ryood/Dual_OTA_VCA/eagle/Dual_OTA_VCA_brd.png

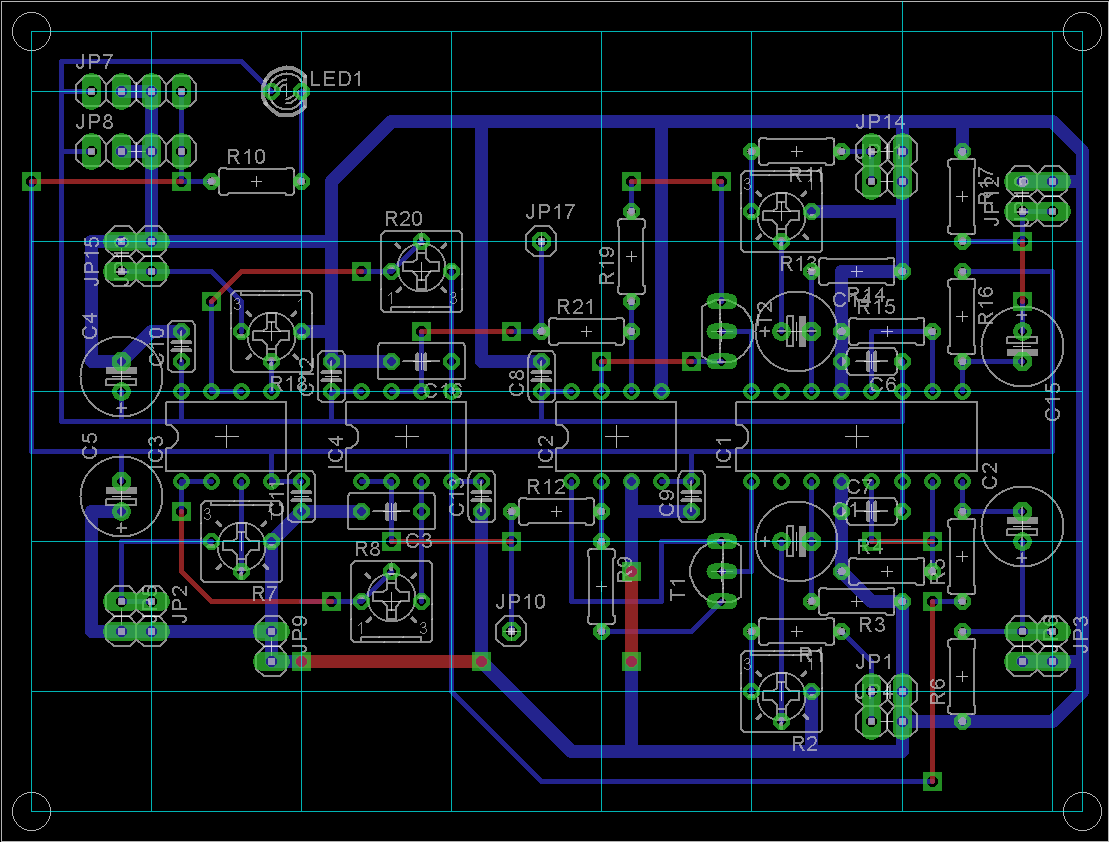
eagle/Dual_OTA_VCA_brd.png
