ryood/Dual_OTA_VCA/eagle/Dual_OTA_VCA_brd_PCB.png

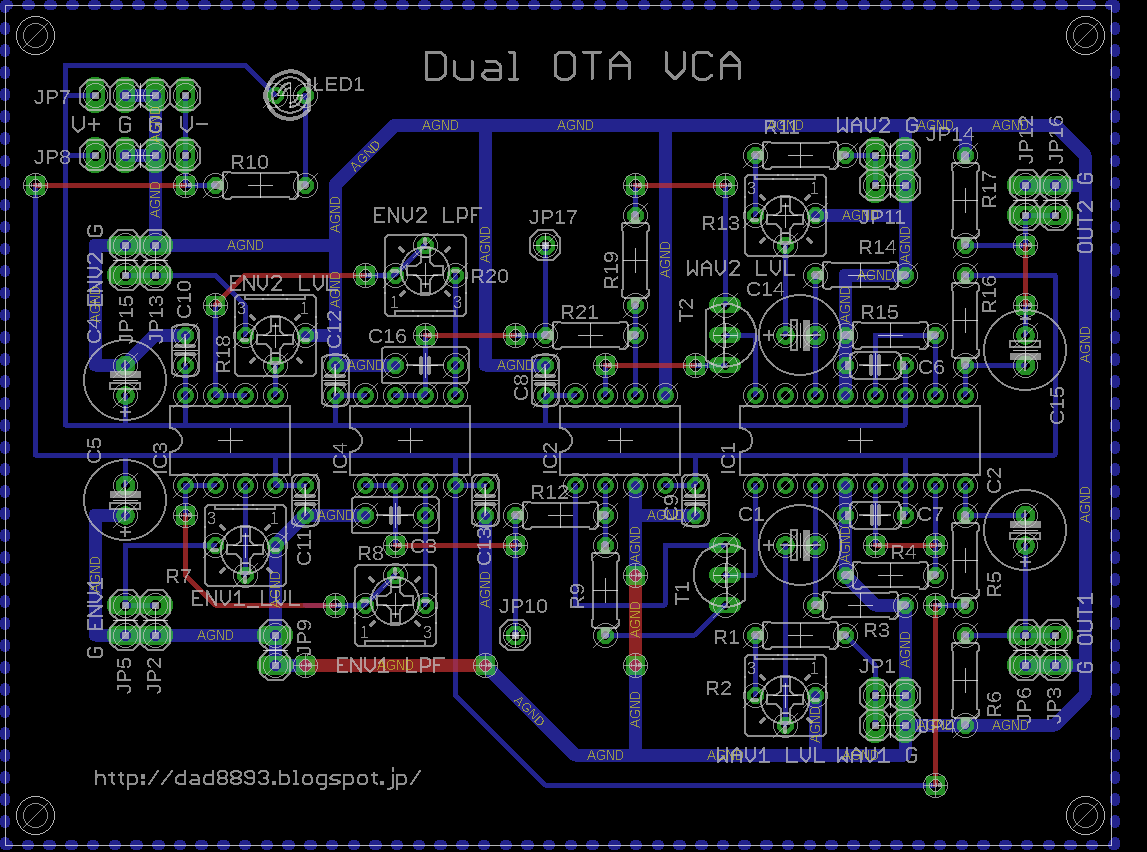
eagle/Dual_OTA_VCA_brd_PCB.png
