ryood/Dual_OTA_VCA/eagle/Dual_OTA_VCA_sch.png

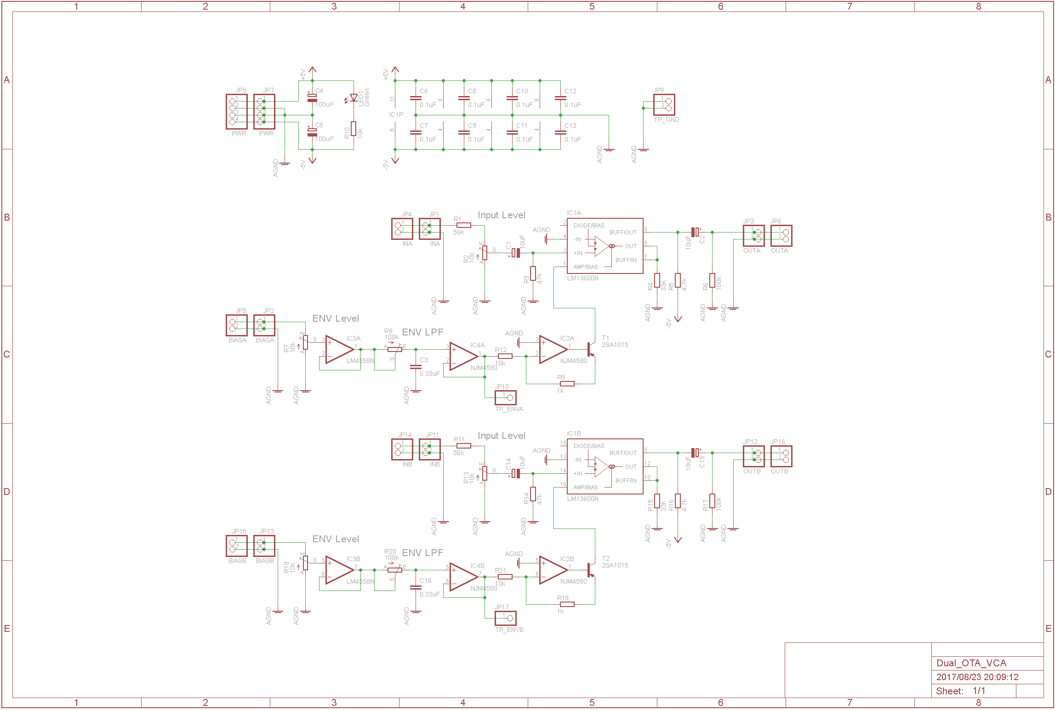
eagle/Dual_OTA_VCA_sch.png
