ryood/Dual_OTA_VCA/OTA_VCAの構成.png

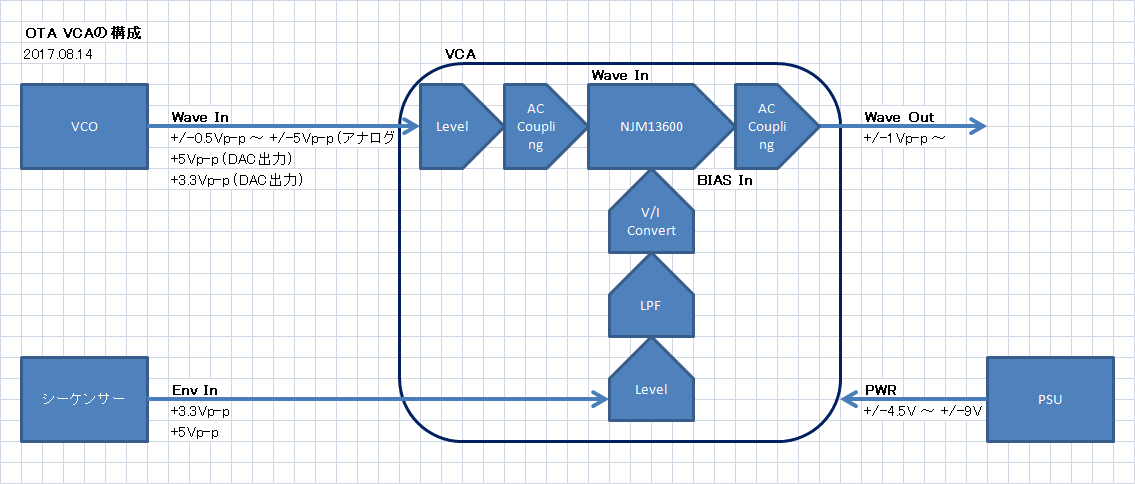
OTA_VCAの構成.png
