ryood/Dual_OTA_VCA/spice/V-I Convert wLPF Amp.png

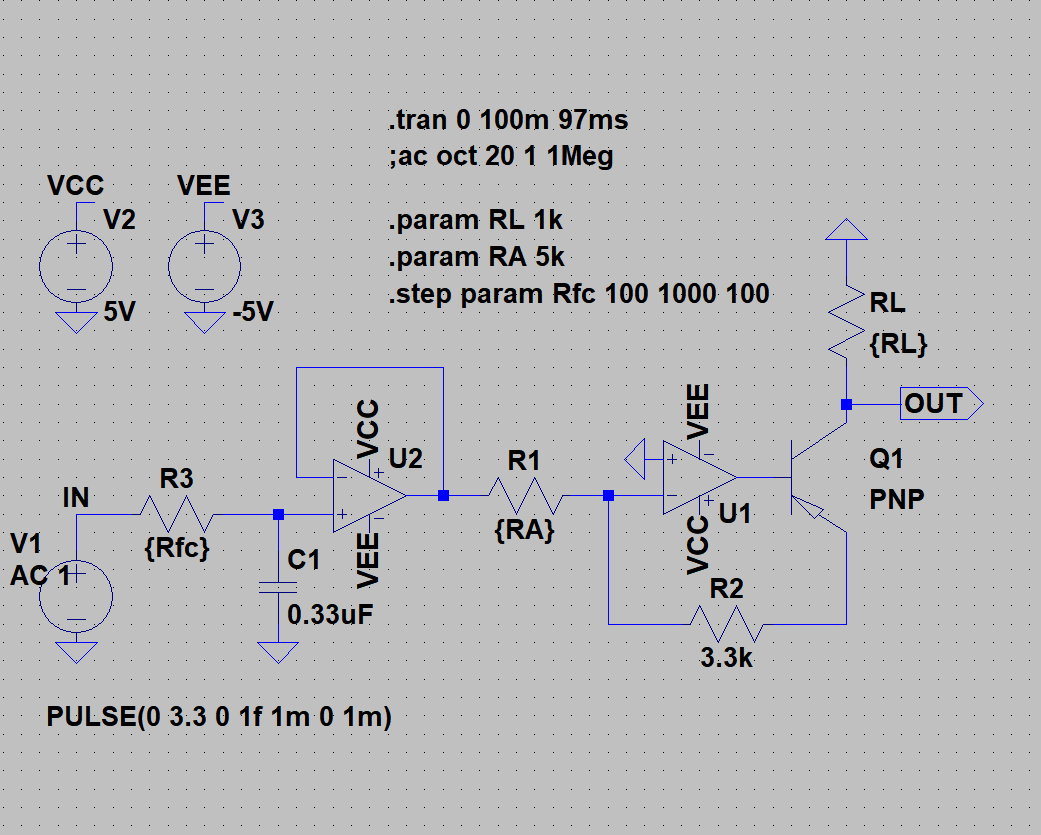
spice/V-I Convert wLPF Amp.png
