ryood/Dual_OTA_VCA/spice/V-I Convert wLPF Att2_sch.png

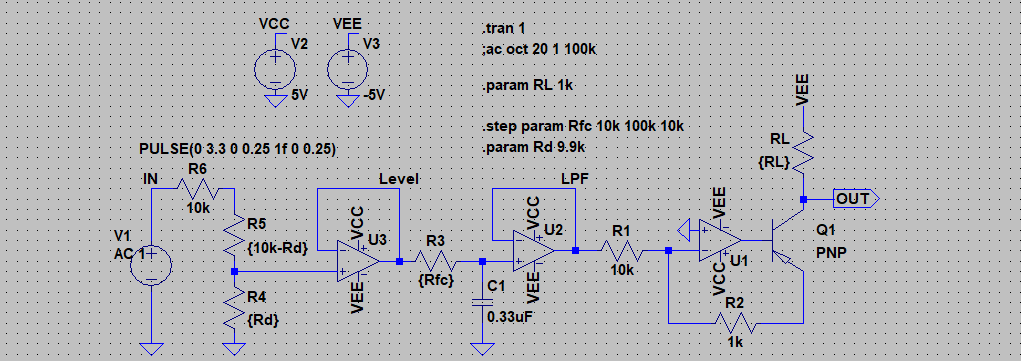
spice/V-I Convert wLPF Att2_sch.png
