ryood/Dual_OTA_VCA/Dual_OTA_VCA_BOM.xlsx

Sheet: Dual_OTA_VCA_BOM (2)
Dual OTA VCA BOM
2018.04.11
Part | Device | Value | Package | Qty | note
C1,C2,C14,C15 | 電解コンデンサ | 10uF | E2,5-7 | 4
C3,C16 | フィルムコンデンサ | 0.33uF | C050-030X075 | 2
C4,C5 | 電解コンデンサ | 100uF | E2,5-7 | 2
C6,C7,C8,C9,C10,C11,C12,C13 | 積セラ | 0.1uF | C050-024X044 | 8
IC1 | OTA | NJM13700 | DIL16 | 1
IC2,IC3,IC4 | OPAMP | NJM4580 | DIL08 | 3
JP1,JP2,JP3,JP9,JP11,JP12,JP13 | ピンヘッダ-1X2 |  | 1X02 | 7
JP4,JP5,JP6,JP14,JP15,JP16 | ピンソケット-1X2 |  | 1X02 | 6
JP7 | AMP/EI-1X4 | PWR | 1X04 | 1
JP8 | ピンソケット-1X4 | PWR | 1X04 | 1
JP10,JP17 | テスト端子 | TP_ENV | 1X01 | 2
LED1 | LED 3mm | Green | LED3MM | 1
R1,R11 | 抵抗 | 56k | 0207/7 | 2
R3,R14 | 抵抗 | 47k | 0207/7 | 2
R4,R15 | 抵抗 | 33k | 0207/7 | 2
R5,R16 | 抵抗 | 4.7k | 0207/7 | 2
R6,R17 | 抵抗 | 100k | 0207/7 | 2
R9,R19 | 抵抗 | 1k | 0207/7 | 2
R10,R12,R21 | 抵抗 | 10k | 0207/7 | 3
R2,R7,R13,R18 | トリマ | 10k | B25P | 4
R8,R20 | トリマ | 100k | B25P | 2
T1,T2 | PNPトランジスタ | 2SA1015 | TO92-ECB | 2
 | ICソケット |  | DIP-16 | 1
 | ICソケット |  | DIP-8 | 3

Sheet: Dual_OTA_VCA_BOM
Dual OTA VCA BOM
2018.04.04
Part | Device | Value | Package | note | note
C1 | 電解コンデンサ | 10uF | E2,5-7
C2 | 電解コンデンサ | 10uF | E2,5-7
C3 | フィルムコンデンサ | 0.33uF | C050-030X075
C4 | 電解コンデンサ | 100uF | E2,5-7
C5 | 電解コンデンサ | 100uF | E2,5-7
C6 | 積セラ | 0.1uF | C050-024X044
C7 | 積セラ | 0.1uF | C050-024X044
C8 | 積セラ | 0.1uF | C025-024X044
C9 | 積セラ | 0.1uF | C025-024X044
C10 | 積セラ | 0.1uF | C025-024X044
C11 | 積セラ | 0.1uF | C025-024X044
C12 | 積セラ | 0.1uF | C025-024X044
C13 | 積セラ | 0.1uF | C025-024X044
C14 | 電解コンデンサ | 10uF | E2,5-7
C15 | 電解コンデンサ | 10uF | E2,5-7
C16 | フィルムコンデンサ | 0.33uF | C050-030X075
IC1 | OTA | NJM13700 | DIL16
IC2 | OPAMP | NJM4580 | DIL08
IC3 | OPAMP | NJM4580 | DIL08
IC4 | OPAMP | NJM4580 | DIL08
JP1 | ピンヘッダ-1X2 | INA | 1X02
JP2 | ピンヘッダ-1X2 | BIASA | 1X02
JP3 | ピンヘッダ-1X2 | OUTA | 1X02
JP4 | ピンソケット-1X2 | INA | 1X02
JP5 | ピンソケット-1X2 | BIASA | 1X02
JP6 | ピンソケット-1X2 | OUTA | 1X02
JP7 | AMP/EI-1X4 | PWR | 1X04
JP8 | ピンソケット-1X4 | PWR | 1X04
JP9 | ピンヘッダ-1X2 | TP_GND | 1X02
JP10 | テスト端子 | TP_ENVA | 1X01
JP11 | ピンヘッダ-1X2 | INB | 1X02
JP12 | ピンヘッダ-1X2 | OUTB | 1X02
JP13 | ピンヘッダ-1X2 | BIASB | 1X02
JP14 | ピンソケット-1X2 | INB | 1X02
JP15 | ピンソケット-1X2 | BIASB | 1X02
JP16 | ピンソケット-1X2 | OUTB | 1X02
JP17 | テスト端子 | TP_ENVB | 1X01
LED1 | LED 3mm | Green | LED3MM
R1 | 抵抗 | 56k | 0207/7
R2 | トリマ | 10k | B25P
R3 | 抵抗 | 47k | 0207/7
R4 | 抵抗 | 33k | 0207/7
R5 | 抵抗 | 4.7k | 0207/7
R6 | 抵抗 | 100k | 0207/7
R7 | トリマ | 10k | B25P
R8 | トリマ | 100k | B25P
R9 | 抵抗 | 1k | 0207/7
R10 | 抵抗 | 10k | 0207/7
R11 | 抵抗 | 56k | 0207/7
R12 | 抵抗 | 10k | 0207/7
R13 | トリマ | 10k | B25P
R14 | 抵抗 | 47k | 0207/7
R15 | 抵抗 | 33k | 0207/7
R16 | 抵抗 | 4.7k | 0207/7
R17 | 抵抗 | 100k | 0207/7
R18 | トリマ | 10k | B25P
R19 | 抵抗 | 1k | 0207/7
R20 | トリマ | 100k | B25P
R21 | 抵抗 | 10k | 0207/7
T1 | PNPトランジスタ | 2SA1015 | TO92-ECB
T2 | PNPトランジスタ | 2SA1015 | TO92-ECB
 | ICソケット | 16pin
 | ICソケット | 8pin
 | ICソケット | 8pin
 | ICソケット | 8pin
