ryood/Dual_OTA_VCA/eagle/OTA_VCA_Test_sch.png

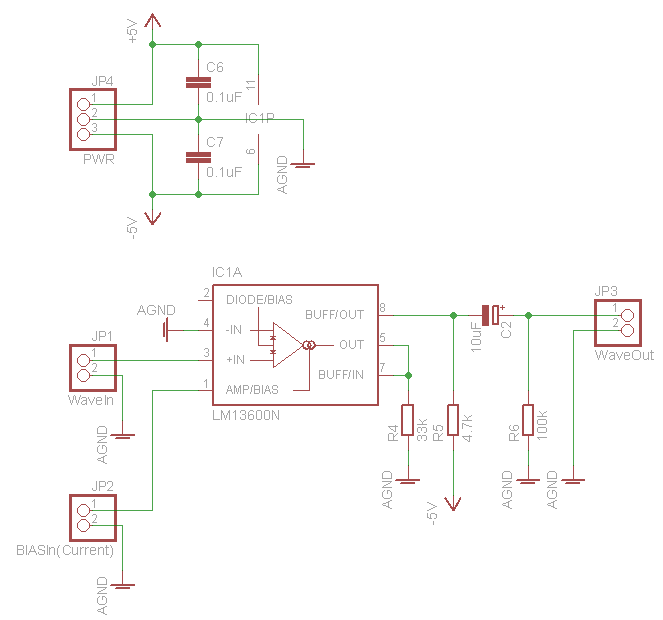
eagle/OTA_VCA_Test_sch.png
