ryood/Dual_OTA_VCA/fritzing/Dual_OTA_VCA_1ch_Test_ブレッドボード.png

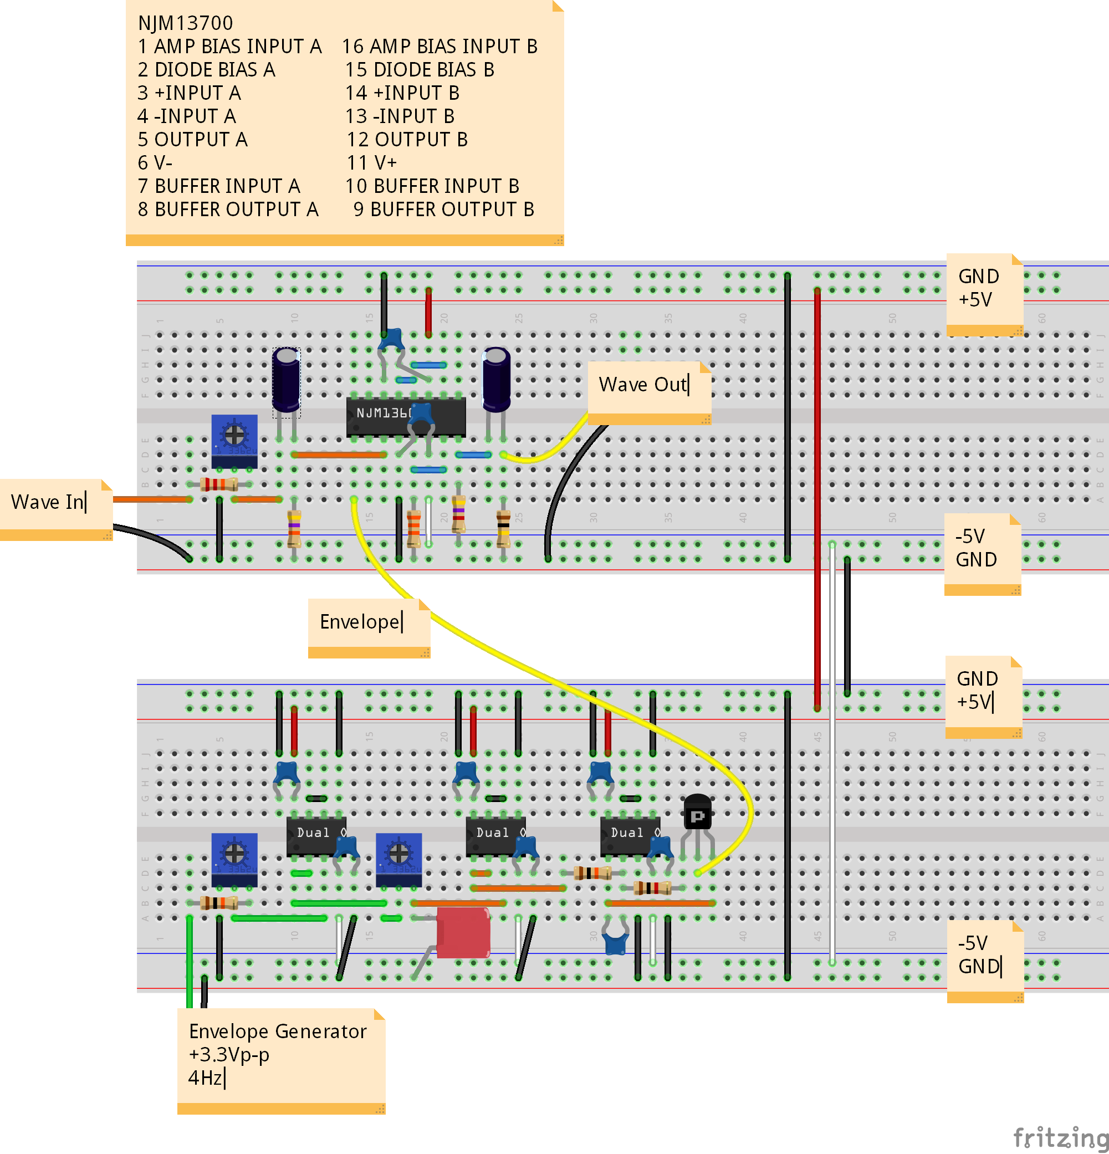
fritzing/Dual_OTA_VCA_1ch_Test_ブレッドボード.png
