ryood/Dual_OTA_VCA/fritzing/Dual_OTA_VCA_ch_Test_ブレッドボード.png

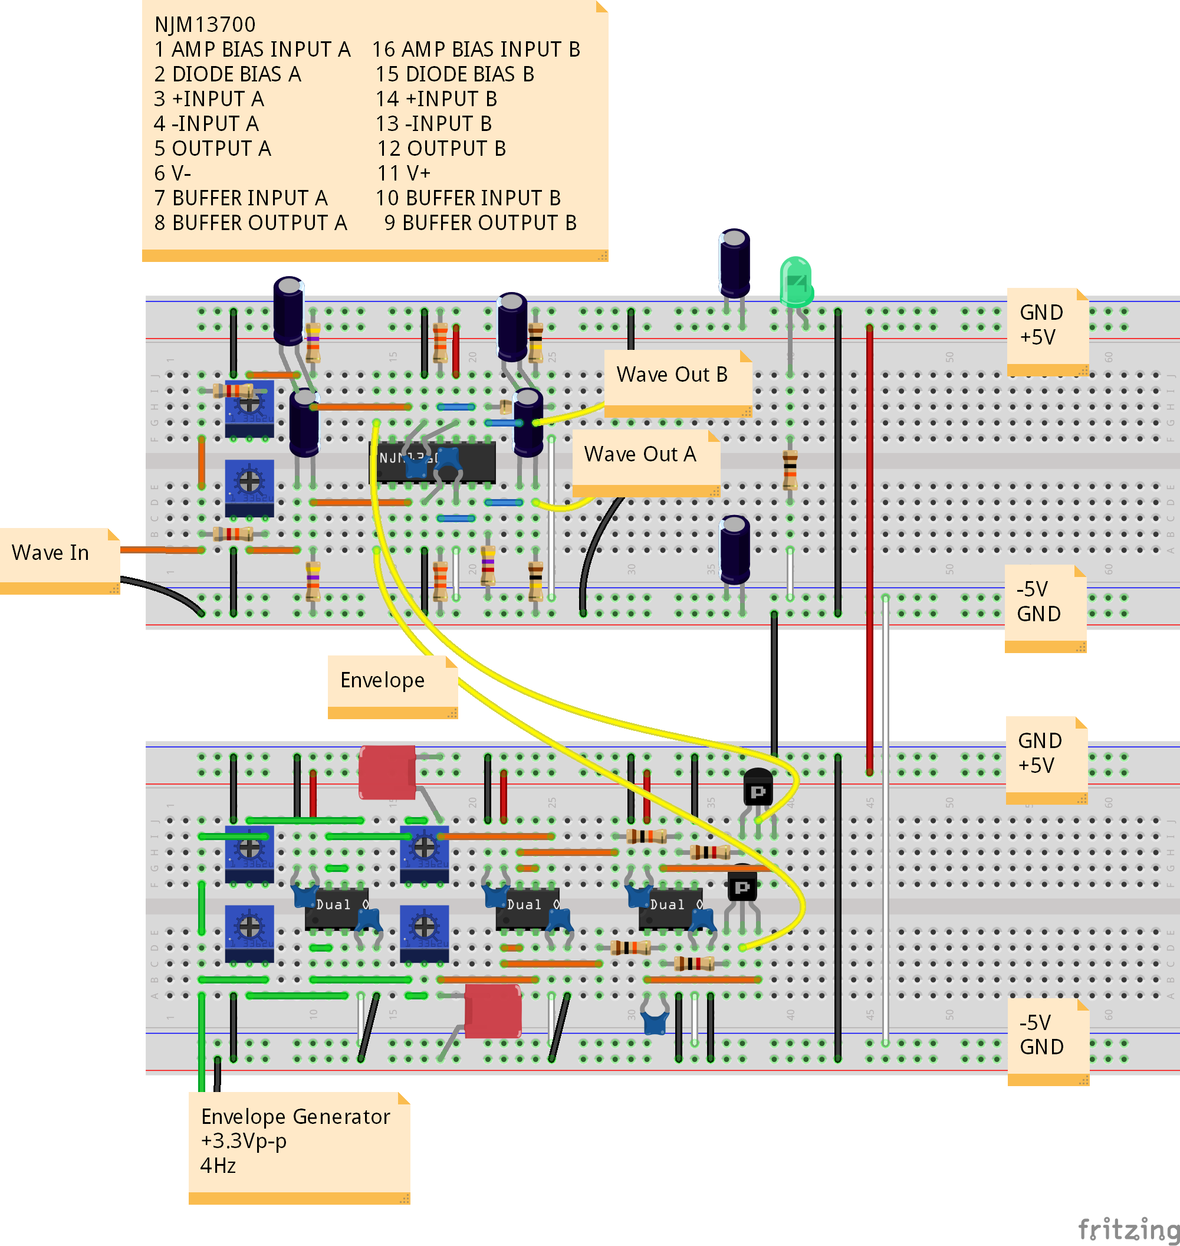
fritzing/Dual_OTA_VCA_ch_Test_ブレッドボード.png
