ryood/Dual_OTA_VCA/fritzing/Dual_OTA_VCA_V-I_Convert_Test_ブレッドボード.png

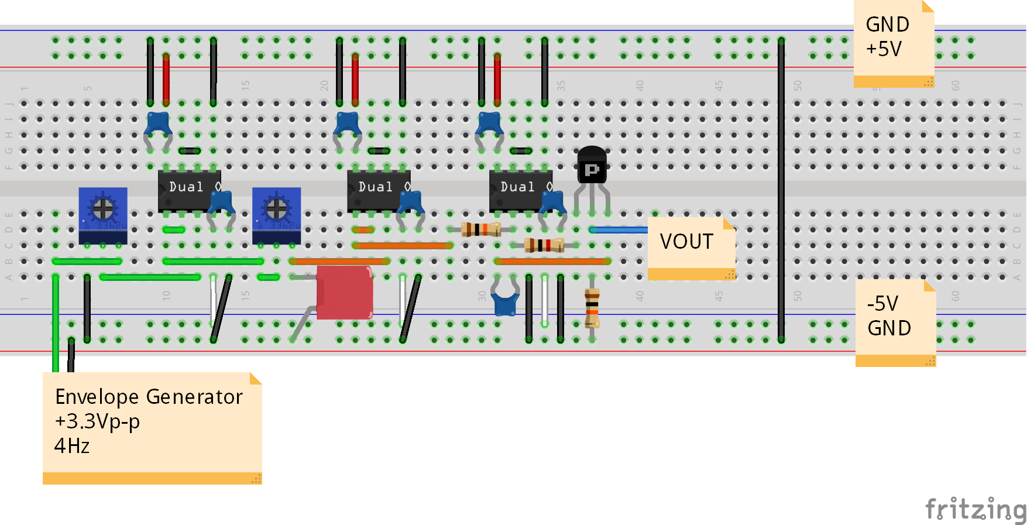
fritzing/Dual_OTA_VCA_V-I_Convert_Test_ブレッドボード.png
