ryood/Dual_OTA_VCA/fritzing/OTA_VCA_BiasIN_2_Test_ブレッドボード.png

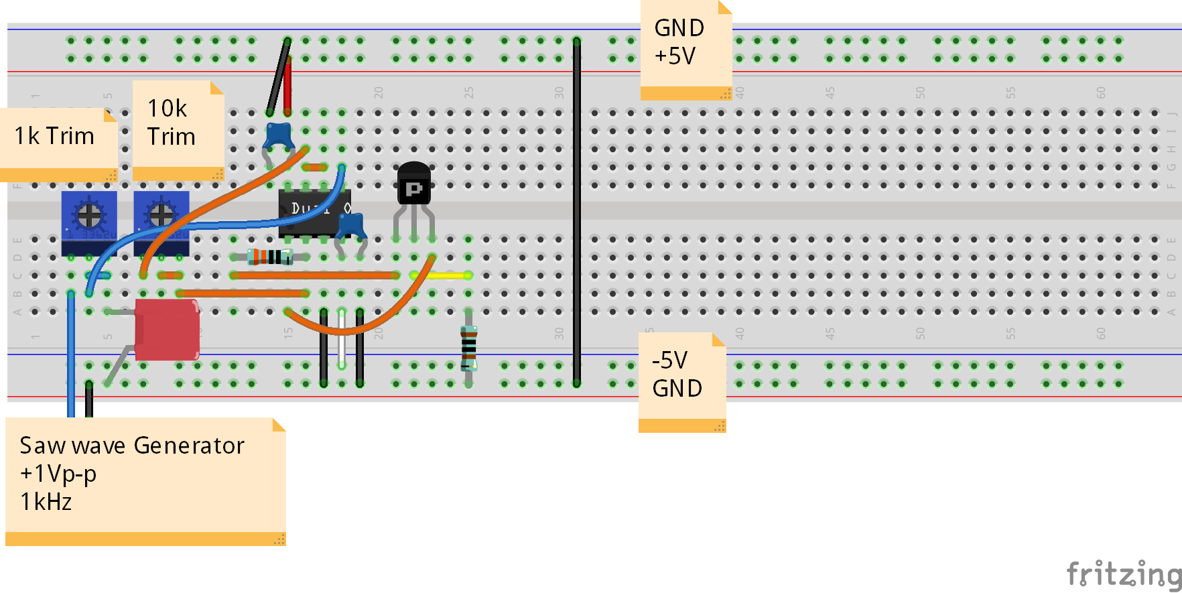
fritzing/OTA_VCA_BiasIN_2_Test_ブレッドボード.png
