ryood/Dual_OTA_VCA/fritzing/OTA_VCA_Dual_Test_ブレッドボード.png

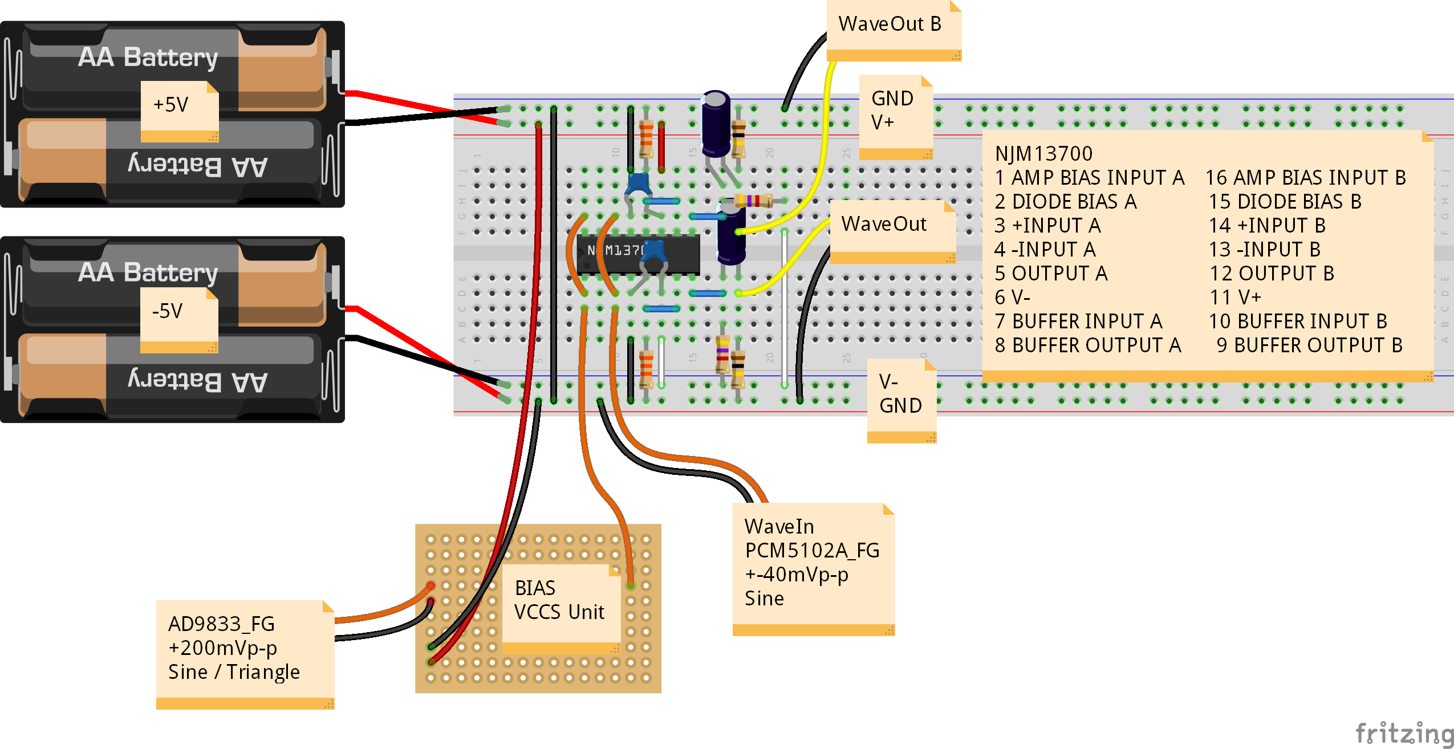
fritzing/OTA_VCA_Dual_Test_ブレッドボード.png
