ryood/Dual_OTA_VCA/fritzing/OTA_VCA_wIVC_Test_ブレッドボード.png

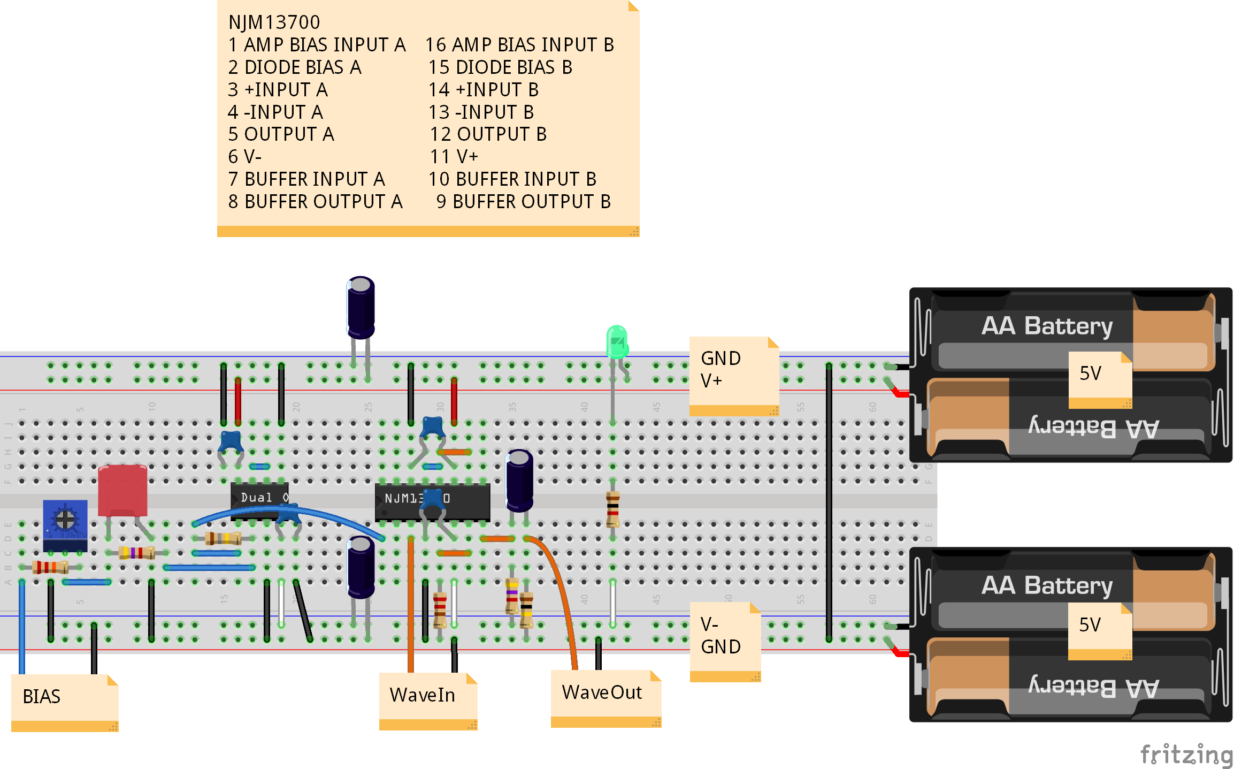
fritzing/OTA_VCA_wIVC_Test_ブレッドボード.png
