ryood/Dual_OTA_VCA/spice/V-I Convert Scott Bernardi.asc

D1: diode
Q1: pnp
R1: res; 30k
R2: res; 68k
R3: res; 100k
R4: res; {RV}
R5: res; {10k-Rv}
U1: UniversalOpamp2
V1: voltage; SINE(0.03 0.03 100)
V2: voltage; 5
V3: voltage; -5
Named nets: 0, VCC, VEE, OUT, IN
.tran 0.3
;dc V1 -1 1 0.1
.step param Rv 4k 6k 200
