ryood/Dual_OTA_VCA/spice/V-I Convert wLPF Att IN=OUT.asc

C1: cap; 0.33uF
Q1: pnp
R1: res; 10k
R2: res; 1k
R3: res; {Rfc}
R4: res; {Rd}
R5: res; {10k-Rd}
RL: res; {RL}
U1: UniversalOpamp2
U2: UniversalOpamp2
U3: UniversalOpamp2
V1: voltage; PULSE(0 3.3 0 0.25 1f 0 0.25); AC 1
V2: voltage; 5V
V3: voltage; -5V
Named nets: 0, VCC, VEE, IN, OUT, LPF, Level
.tran 1
.param RL 10k
;ac oct 20 1 100k
.step param Rfc 10k 100k 10k
.param Rd 9.9k
