ryood/Dual_OTA_VCA/spice/V-I Convert wLPF Att.asc

C1: cap; 0.33uF
Q1: pnp
R1: res; {RA}
R2: res; 1k
R3: res; {Rfc}
RL: res; {RL}
U1: UniversalOpamp2
U2: UniversalOpamp2
V1: voltage; PULSE(0 3.3 0 1f 0.6 0 0.5); AC 1
V2: voltage; 5V
V3: voltage; -5V
Named nets: 0, VCC, VEE, IN, OUT
.tran 1
.param RL 1k
;ac oct 20 1 1Meg
.step param Rfc 10k 100k 10k
.param RA 3.3k
