ryood/Dual_OTA_VCA/spice/V-I Convert wLPF Amp.asc

C1: cap; 0.33uF
Q1: pnp
R1: res; {RA}
R2: res; 330
R3: res; {Rfc}
RL: res; {RL}
U1: UniversalOpamp2
V1: voltage; PULSE(0 5 0 0.5m 0.5m 0 1m); AC 1
V2: voltage; 5V
V3: voltage; -5V
Named nets: 0, VCC, VEE, IN, OUT
.tran 0 100m 97ms
.param RL 1k
;ac oct 20 1 1Meg
.step param Rfc 100 1k 100
.param RA 1k
