ryood/Dual_OTA_VCA/spice/V-I Convert.asc

Q1: pnp
R1: res; 10k
R2: res; 1.8k
RL: res; {RL}
U1: UniversalOpamp2
V1: voltage; SINE(0.5 0.5 1k)
V2: voltage; 5V
V3: voltage; -5V
Named nets: 0, VCC, VEE, IN, OUT
.tran 3m
.param RL 1k
