ryood/Dual_OTA_VCA/(list of files, drawings)

Other design files:
fritzing/Dual_OTA_VCA_1ch_Test.fzz
fritzing/Dual_OTA_VCA_ch_Test.fzz
fritzing/Dual_OTA_VCA_V-I_Convert_Test.fzz
fritzing/Dual_OTA_VCA_VCCS_Unit_Test.fzz
fritzing/OTA_VCA_Arduino_MCP4922_Test.fzz
fritzing/OTA_VCA_BiasIN_2_Test.fzz
fritzing/OTA_VCA_BiasIN_3_Test.fzz
fritzing/OTA_VCA_BiasIN_4_Test.fzz
fritzing/OTA_VCA_BiasIN_Test.fzz
fritzing/OTA_VCA_Nucleo_Test.fzz
fritzing/OTA_VCA_wIVC_Test.fzz
