ryood/Dual_OTA_VCA/eagle/Dual_OTA_VCA/Dual_OTA_VCA.brd

## EAGLE design eagle/Dual_OTA_VCA/Dual_OTA_VCA.brd (2018-03-25)

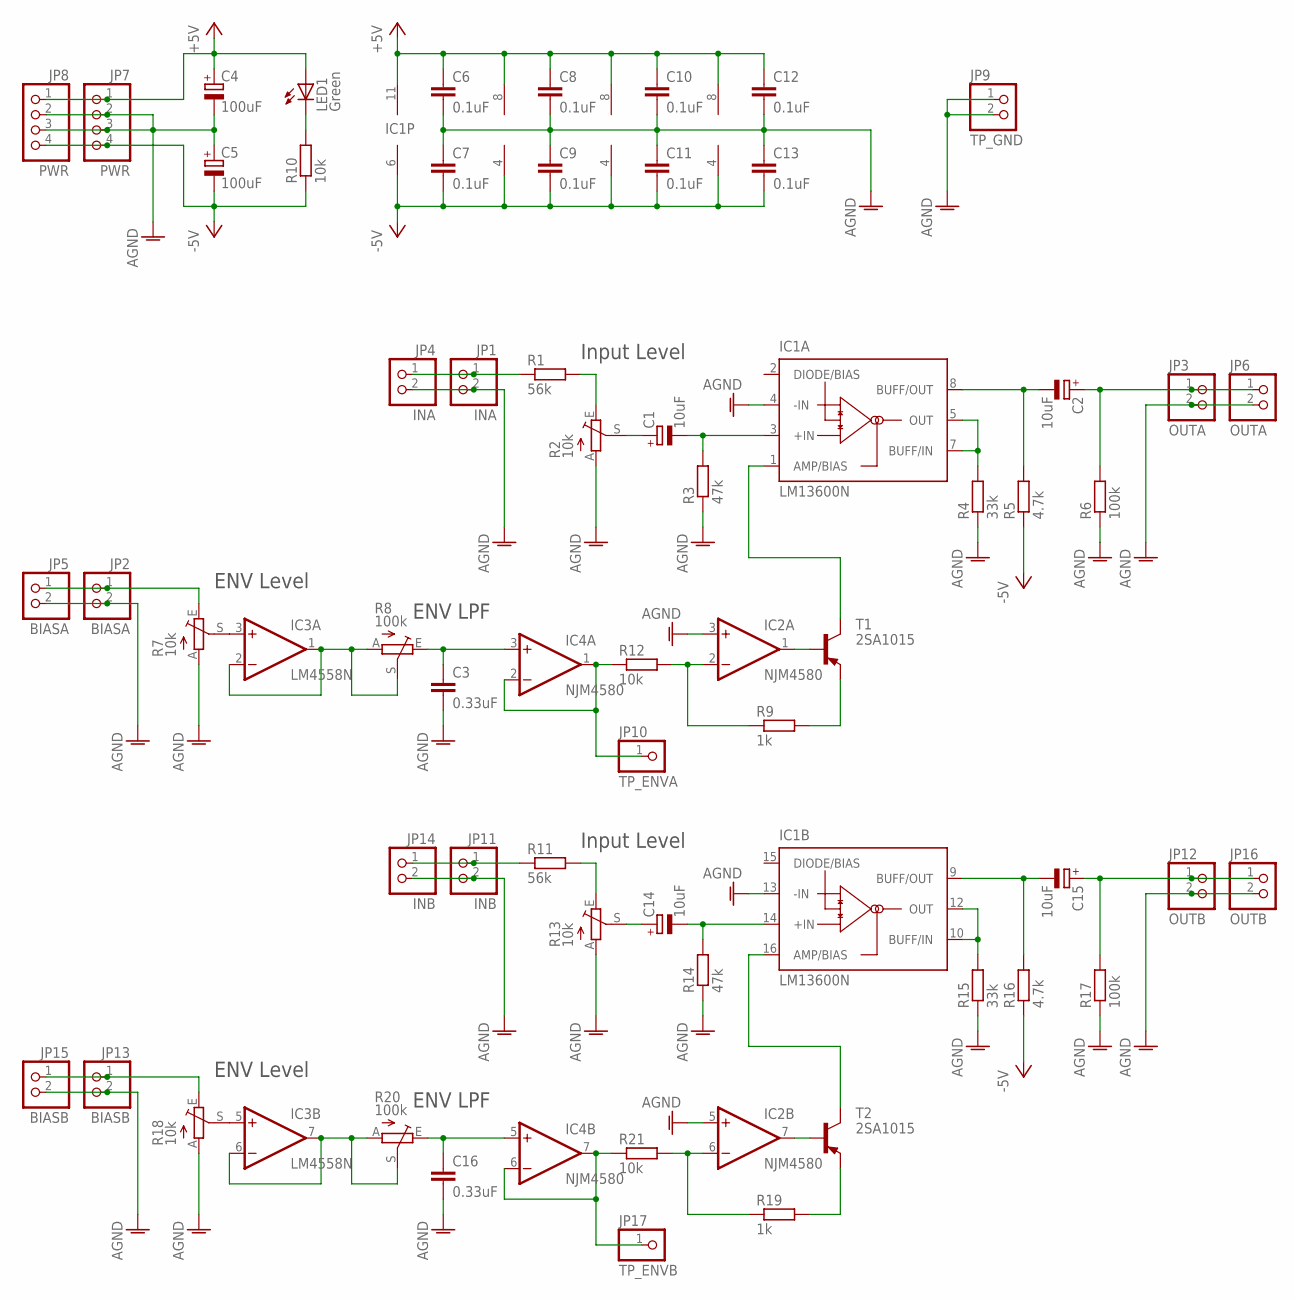
[picture p16: schematic Dual_OTA_VCA.sch]

Parts:
C1, C2, C14, C15: 10uF; E2,5-7
C3, C16: 0.33uF; C050-030X075
C4, C5: 100uF; E2,5-7
C6, C7: 0.1uF; C050-024X044
C8, C9, C10, C11, C12, C13: 0.1uF; C025-024X044
IC1: LM13600N; DIL16
IC2, IC4: NJM4580; DIL08
IC3: LM4558N; DIL08
JP1, JP4: INA; 1X02
JP2, JP5: BIASA; 1X02
JP3, JP6: OUTA; 1X02
JP7, JP8: PWR; 1X04
JP9: TP_GND; 1X02
JP10: TP_ENVA; 1X01
JP11, JP14: INB; 1X02
JP12, JP16: OUTB; 1X02
JP13, JP15: BIASB; 1X02
JP17: TP_ENVB; 1X01
LED1: Green; LED3MM
R1, R11: 56k; 0207/7
R2, R7, R13, R18: 10k; B25P
R3, R14: 47k; 0207/7
R4, R15: 33k; 0207/7
R5, R16: 4.7k; 0207/7
R6, R17: 100k; 0207/7
R8, R20: 100k; B25P
R9, R19: 1k; 0207/7
R10, R12, R21: 10k; 0207/7
T1, T2: 2SA1015; TO92-ECB

Connections:
+5V: C4.+, C6.1, C8.1, C10.1, C12.1, IC1.11 (V+), IC2.8 (V+), IC3.8 (V+), IC4.8 (V+), JP7.1, JP8.1, LED1.A
-5V: C5.-, C7.2, C9.2, C11.2, C13.2, IC1.6 (V-), IC2.4 (V-), IC3.4 (V-), IC4.4 (V-), JP7.4, JP8.4, R5.1, R10.1, R16.1
AGND: C3.2, C4.-, C5.+, C6.2, C7.1, C8.2, C9.1, C10.2, C11.1, C12.2, C13.1, C16.2, IC1.4 (-IN), IC1.13 (-IN), IC2.3 (+IN), IC2.5 (+IN), JP1.2, JP2.2, JP3.2, JP4.2, JP5.2, JP6.2, JP7.2, JP7.3, JP8.2, JP8.3, JP9.1, JP9.2, JP11.2, JP12.2, JP13.2, JP14.2, JP15.2, JP16.2, R2.A, R3.1, R4.1, R6.1, R7.A, R13.A, R14.1, R15.1, R17.1, R18.A
unnamed: JP1.1, JP4.1, R1.1
unnamed: R1.2, R2.E
unnamed: C1.+, R2.S
unnamed: C1.-, IC1.3 (+IN), R3.2
unnamed: IC1.5 (OUT), IC1.7 (BUFF/IN), R4.2
unnamed: C2.-, IC1.8 (BUFF/OUT), R5.2
unnamed: IC4.1 (OUT), IC4.2 (-IN), JP10.1, R12.1
unnamed: C2.+, JP3.1, JP6.1, R6.2
unnamed: IC2.2 (-IN), R9.1, R12.2
unnamed: JP2.1, JP5.1, R7.E
unnamed: R9.2, T1.E
unnamed: IC2.1 (OUT), T1.B
unnamed: IC3.5 (+IN), R18.S
unnamed: IC1.1 (AMP/BIAS), T1.C
unnamed: LED1.K (C), R10.2
unnamed: JP11.1, JP14.1, R11.1
unnamed: IC3.3 (+IN), R7.S
unnamed: IC3.1 (OUT), IC3.2 (-IN), R8.A, R8.S
unnamed: C3.1, IC4.3 (+IN), R8.E
unnamed: R11.2, R13.E
unnamed: C14.+, R13.S
unnamed: C14.-, IC1.14 (+IN), R14.2
unnamed: IC1.10 (BUFF/IN), IC1.12 (OUT), R15.2
unnamed: C15.-, IC1.9 (BUFF/OUT), R16.2
unnamed: C15.+, JP12.1, JP16.1, R17.2
unnamed: JP13.1, JP15.1, R18.E
unnamed: IC2.6 (-IN), R19.1, R21.2
unnamed: R19.2, T2.E
unnamed: IC2.7 (OUT), T2.B
unnamed: IC1.16 (AMP/BIAS), T2.C
unnamed: IC3.6 (-IN), IC3.7 (OUT), R20.A, R20.S
unnamed: C16.1, IC4.5 (+IN), R20.E
unnamed: IC4.6 (-IN), IC4.7 (OUT), JP17.1, R21.1

Notes on the sheet:
ENV LPF
ENV Level
Input Level

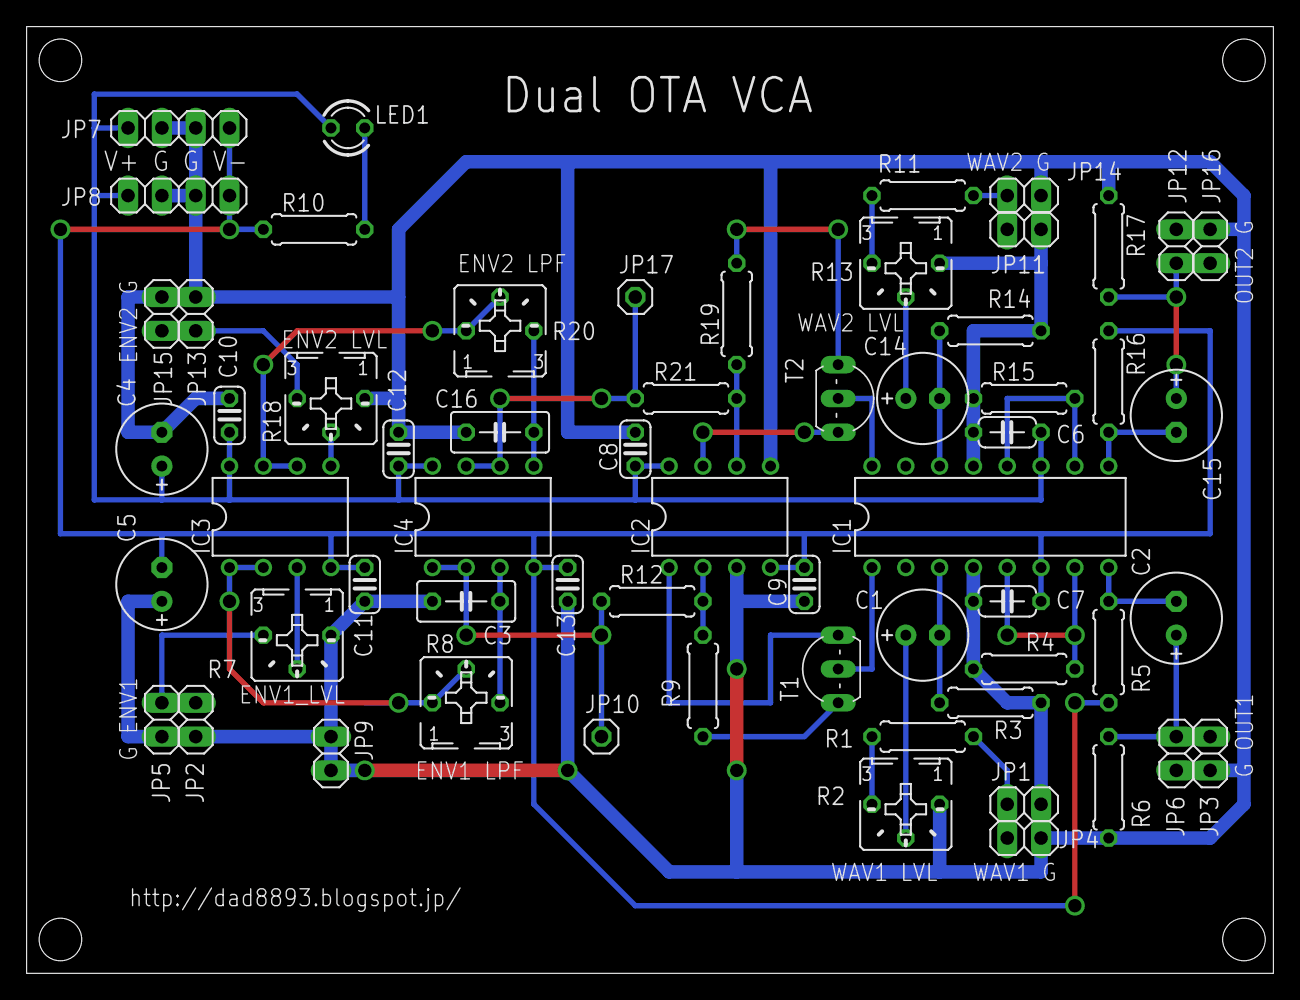
[picture p17: board Dual_OTA_VCA.brd from above]

Board: 2 copper layers, 93.7 x 71.1 mm, 61 parts (0 on the bottom side), 36 nets.
