ryood/Dual_OTA_VCA/(commit log)

2017-08-13 Add Bias IN Test
    [Dual_OTA_VCA.sch, OTA_VCA_BiasIN_2_Test.fzz, OTA_VCA_BiasIN_Test.fzz]
2017-08-13 ADD OTA_VCA with I/V Convert Test
    [OTA_VCA_wIVC_Test.fzz]
2017-08-14 Add OTA VCAの構成
    [OTA VCAの構成.xlsx]
2017-08-14 Update OTA_VCAの構成
    [OTA VCAの構成.xlsx]
2017-08-14 Add V-I Convert Test
    [OTA_VCA_BiasIN_3_Test.fzz, OTA_VCA_BiasIN_4_Test.fzz, OTA_VCA_wIVC_Test.fzz]
2017-08-14 Update OTA VCAの構成
    [OTA VCAの構成.xlsx]
2017-08-17 Update Schematics
    [Dual_OTA_VCA.sch, OTA_VCA_BiasIN_3_Test.fzz]
2017-08-17 1ch Test
    [Dual_OTA_VCA.sch, Dual_OTA_VCA_V-I_Convert_Test.fzz, Dual_OTA_VCA_VCCS_Unit_Test.fzz]
2017-08-17 begin 2ch
    [Dual_OTA_VCA.brd, Dual_OTA_VCA.sch]
2017-08-19 before Parts layout
    [Dual_OTA_VCA.brd]
2017-08-20 Update the eagle files
    [Dual_OTA_VCA.brd, Dual_OTA_VCA.sch]
2017-08-23 Board Design
    [Dual_OTA_VCA.brd, Dual_OTA_VCA.sch, Dual_OTA_VCA_1ch_Test.fzz, Dual_OTA_VCA_ch_Test.fzz]
2017-08-23 Update Board Design
    [Dual_OTA_VCA.brd]
2017-08-29 Update Board Design. Add テスト表
    [Dual OTA VCA テスト表.xlsx, Dual_OTA_VCA.brd]
2018-03-25 Add: gerber files
    [Dual_OTA_VCA.brd]
2018-04-04 Update: テスト表(PCB)
    [Dual OTA VCA テスト表.xlsx]
2018-04-04 Add: Dual_OTA_VCA_BOM
    [Dual_OTA_VCA_BOM.xlsx]
2018-05-20 Add BOM
    [Dual_OTA_VCA_BOM.xlsx]
